skot/hashat/README.md

WIP - don't order PCBs yet!

# hashat
A Bitcoin ASIC mining HAT for Raspberry Pi

Some of the DIY mining enthusiats from the Open Source Miners United Discord have been scheming to make a Raspberry Pi Hat! Here is what we have so far.

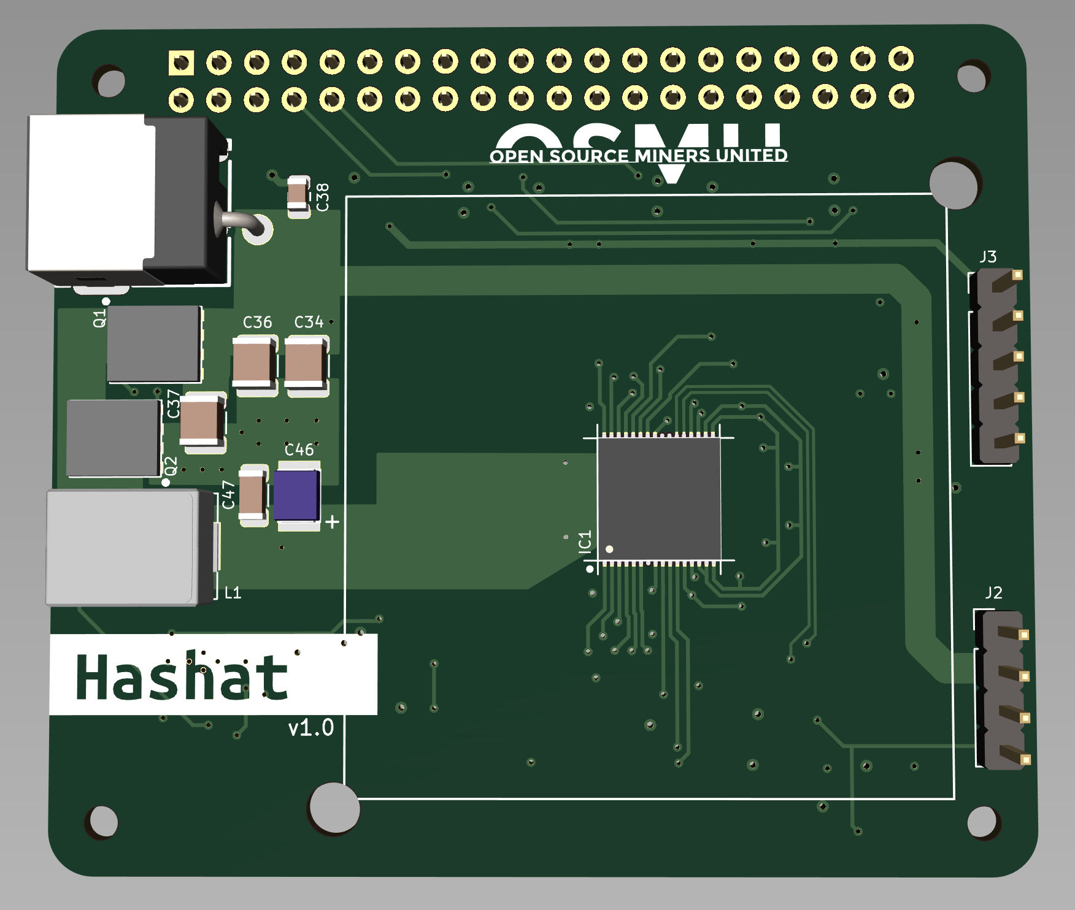
[picture p1: doc/render.png]
KiCAD Render
