skot/hashat/doc/OSMU-black.png

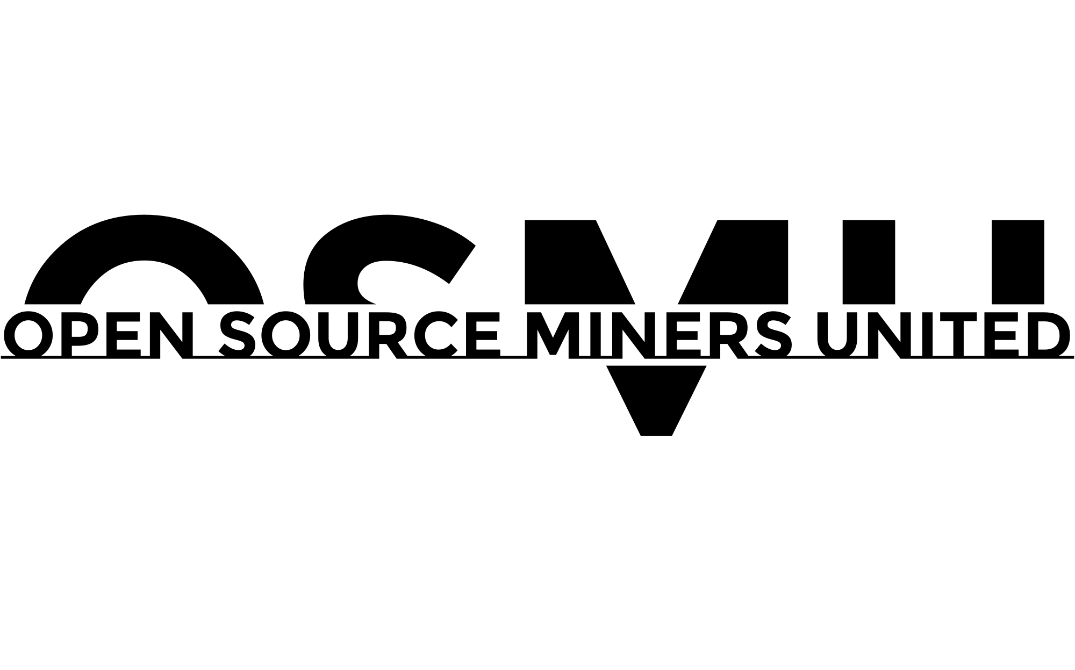
doc/OSMU-black.png
