skot/hashat/doc/OSMU-white.png

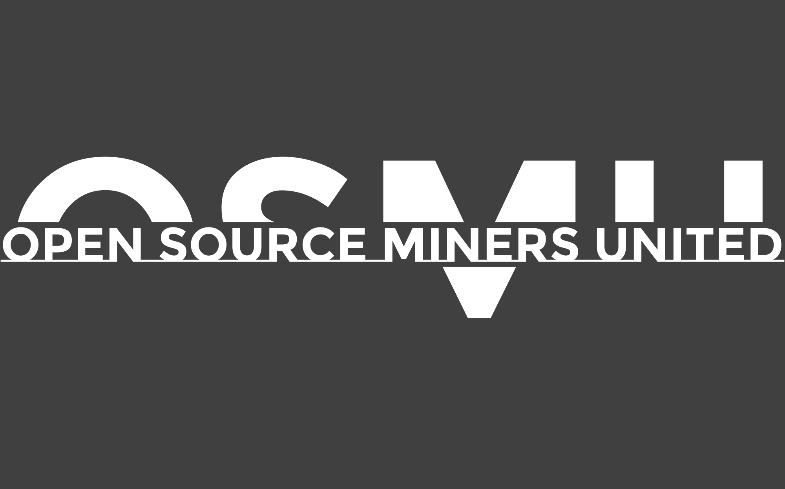
doc/OSMU-white.png
