skot/hashat/Manufacturing Files/Hashat BOM.xlsx

Sheet: BOM
Qty | Ref Des | Value | DK | PARTNO | DNP
18 | C2, C3, C4, C5, C6, C8, C10, C11, C12, C14, C15, C16, C17, C18, C19, C22, C24, C44 | 1uF | 587-5514-1-ND | EMK105BJ105MV-F
12 | C7, C9, C21, C23, C25, C26, C29, C31, C33, C35, C42, C48 | 0.1uF | 1292-1639-1-ND | 0402X104K100CT
1 | C13 | 330uF | 718-1028-1-ND | 293D337X9010E2TE3
1 | C20 | 2.2uF | 478-KGM05AR51A225MHCT-ND | KGM05AR51A225MH
1 | C28 | 220uF | 732-8422-1-ND | 865080345012
1 | C32 | 470pF | 1276-1566-1-ND | CL05B471KB5NNNC
3 | C34, C36, C37 | 47uF | 490-6539-1-ND | GRM32ER61C476KE15L
1 | C38 | 1uF | 1276-6471-1-ND | CL21B105KOFNNNG
1 | C39 | 3.3nF | 1276-1552-1-ND | CL05B332KB5NNNC
1 | C40 | 180pF | 311-1114-1-ND | CC0805JRNPO9BN181
1 | C41 | 1.5nF | 311-1128-1-ND | CC0805KRX7R9BB152
1 | C43 | 10uF | 1276-1096-1-ND | CL21A106KOQNNNE
1 | C45 | 470pF | 1292-1580-1-ND | 0805B471K500CT
1 | C46 | 220uF | P16200CT-ND | 2R5TPE220MAFB
1 | C47 | 100uF | 445-6008-1-ND | C3216X5R0J107M160AB
1 | DC1 | DC-044K-D025
1 | IC1 | BM1397_mode1
1 | J1 | Raspberry_Pi_2_3
1 | J2 | Conn_01x04
1 | J3 | Conn_01x05
1 | L1 | 150nH | 513-1568-1-ND | FP1005R1-R15-R
2 | Q1, Q2 | CSD17311Q5 | 296-27625-1-ND | CSD17311Q5
1 | R1 | 1k | YAG2306CT-ND | RT0402BRE071KL | DNP
1 | R2 | 1k | YAG2306CT-ND | RT0402BRE071KL
2 | R3, R4 | 0 | RMCF0402ZT0R00 | RMCF0402ZT0R00CT-ND | DNP
1 | R5 | 0 | RMCF0402ZT0R00 | RMCF0402ZT0R00CT-ND
2 | R6, R9 | 10k | 311-10KJRCT-ND | RC0402JR-0710KL
2 | R7, R8 | 100 | RMCF0402FT100RCT-ND | RMCF0402FT100R
1 | R10 | 3.83k | 311-3.83KLRCT-ND | RC0402FR-073K83L
1 | R11 | 100k | 311-100KJRCT-ND | RC0402JR-07100KL
1 | R12 | 4.12k | RMCF0402FT4K12CT-ND | RMCF0402FT4K12
1 | R13 | 1.33k | 311-1.33KLRCT-ND | RC0402FR-071K33L
1 | R14 | 4.99k | 311-4.99KLRCT-ND | RC0402FR-074K99L
1 | R15 | 3.32k | 311-3.32KLRCT-ND | RC0402FR-073K32L
1 | R16 | 80k | 311-80.6KLRCT-ND | RC0402FR-0780K6L
1 | R17 | 80k | 311-80.6KLRCT-ND | RC0402FR-0780K6L | DNP
1 | R36 | 5.6k | 13-RC0402FR-135K6LCT-ND | RC0402FR-135K6L
1 | U2 | LN1134A182MR-G
3 | U3, U5, U8 | SN74LVC1T45DBVR
1 | U4 | SGM2036-ADJYN5G/TR
1 | U7 | EMC2101-R | EMC2101-R-ACZL-CT-ND | EMC2101-R-ACZL-TR
1 | U9 | TPS40305 | 296-37445-1-ND | TPS40305DRCR
1 | U10 | DS4432U+ | DS4432U+-ND | DS4432U+
1 | X1 | OT322525MJBA4SL

Sheet: DK Order
Qty | Ref Des | DK
18 | C2, C3, C4, C5, C6, C8, C10, C11, C12, C14, C15, C16, C17, C18, C19, C22, C24, C44 | 587-5514-1-ND
12 | C7, C9, C21, C23, C25, C26, C29, C31, C33, C35, C42, C48 | 1292-1639-1-ND
1 | C13 | 718-1028-1-ND
1 | C20 | 478-KGM05AR51A225MHCT-ND
1 | C28 | 732-8422-1-ND
1 | C32 | 1276-1566-1-ND
3 | C34, C36, C37 | 490-6539-1-ND
1 | C38 | 1276-6471-1-ND
1 | C39 | 1276-1552-1-ND
1 | C40 | 311-1114-1-ND
1 | C41 | 311-1128-1-ND
1 | C43 | 1276-1096-1-ND
1 | C45 | 1292-1580-1-ND
1 | C46 | P16200CT-ND
1 | C47 | 445-6008-1-ND
1 | DC1
1 | IC1
1 | J1
1 | J2
1 | J3
1 | L1 | 513-1568-1-ND
2 | Q1, Q2 | 296-27625-1-ND
1 | R2 | YAG2306CT-ND
1 | R5 | RMCF0402ZT0R00
2 | R6, R9 | 311-10KJRCT-ND
2 | R7, R8 | RMCF0402FT100RCT-ND
1 | R10 | 311-3.83KLRCT-ND
1 | R11 | 311-100KJRCT-ND
1 | R12 | RMCF0402FT4K12CT-ND
1 | R13 | 311-1.33KLRCT-ND
1 | R14 | 311-4.99KLRCT-ND
1 | R15 | 311-3.32KLRCT-ND
1 | R16 | 311-80.6KLRCT-ND
1 | R36 | 13-RC0402FR-135K6LCT-ND
1 | U2
3 | U3, U5, U8
1 | U4
1 | U7 | EMC2101-R-ACZL-CT-ND
1 | U9 | 296-37445-1-ND
1 | U10 | DS4432U+-ND
1 | X1
