skot/hashat/3d/DRC0010J.stp

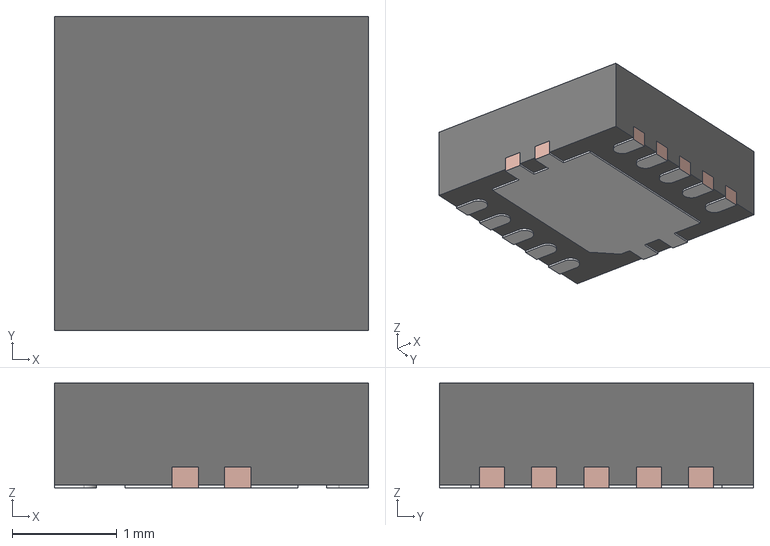
[picture p4: CAD file, 2023-06-09]
3d/DRC0010J.stp
3.00 x 3.00 x 1.00 mm
BODY-SON
FRAME-DRC0010J
