skot/hashat/3d/CUI_DEVICES_PJ-202AH.step

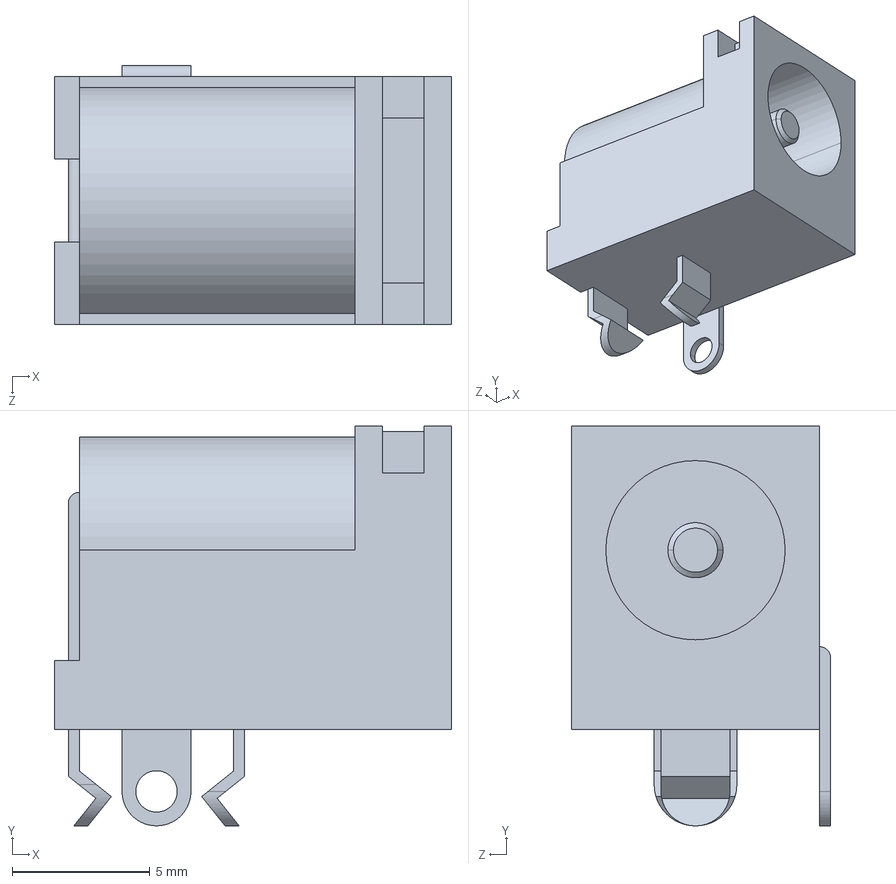
[picture p8: CAD file, 2023-04-22]
3d/CUI_DEVICES_PJ-202AH.step
14.4 x 14.5 x 9.40 mm
