skot/hashat/3d/470531000.stp

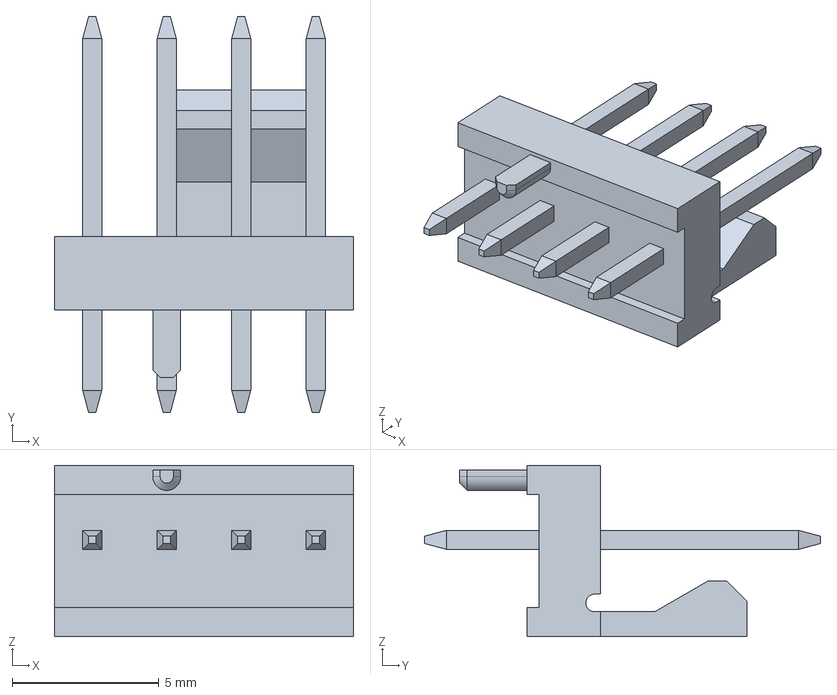
[picture p9: CAD file, 2023-05-16]
3d/470531000.stp
10.2 x 13.5 x 5.84 mm
