skot/hashat/Hashat.kicad_pcb

## KiCad design Hashat.kicad_pcb (2023-06-09)

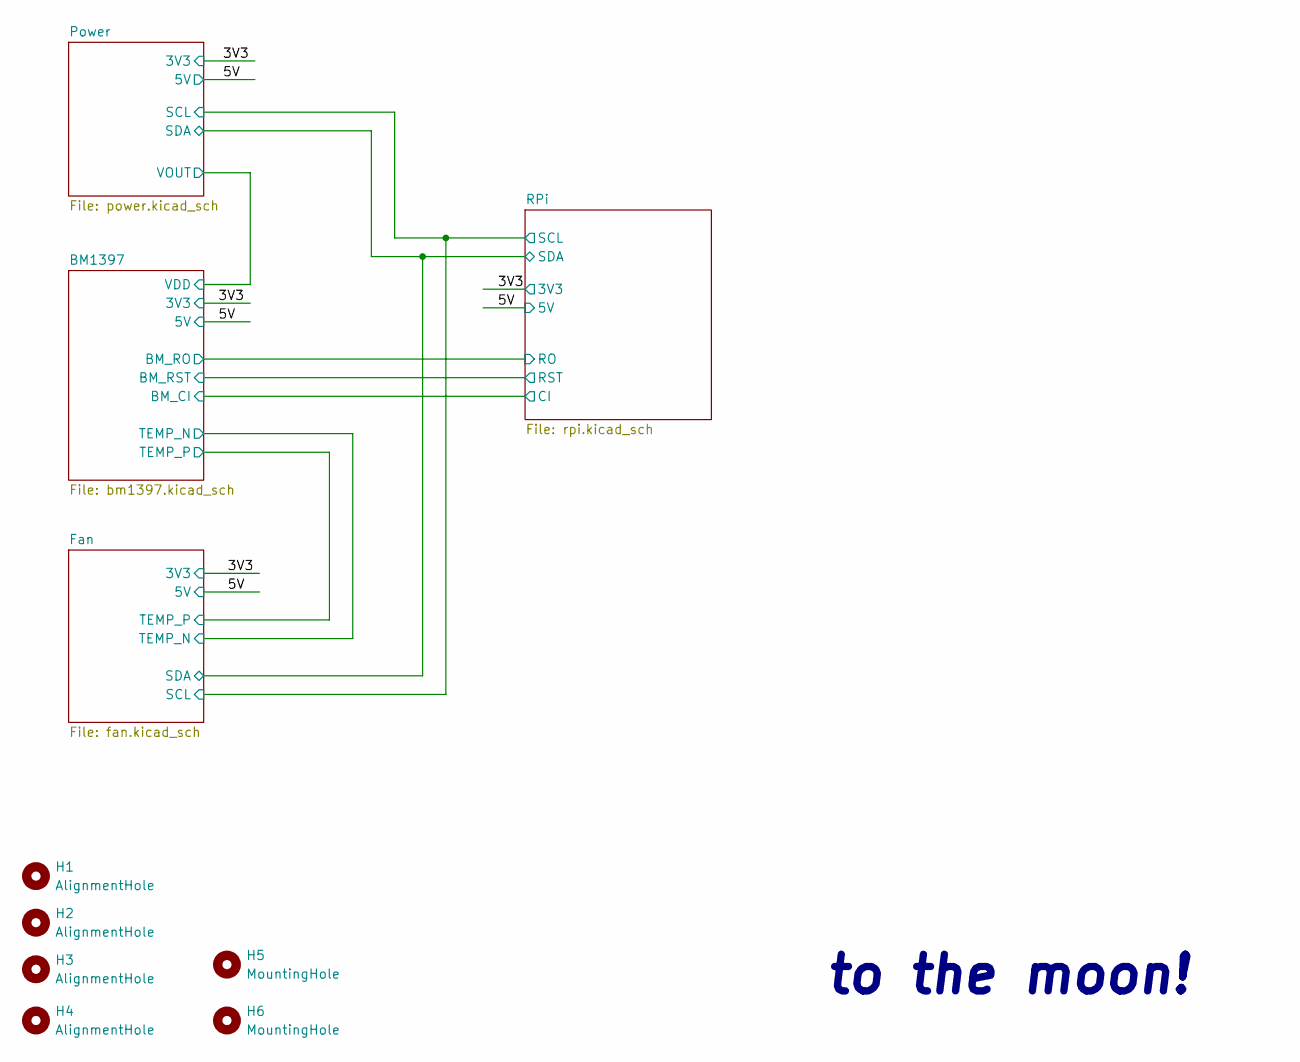
[picture p10: schematic Hashat.kicad_sch, The Hashat]

Parts:
H1, H2, H3, H4: AlignmentHole; MountingHole_2.2mm_M2
H5, H6: MountingHole; MountingHole_3.5mm

Notes on the sheet:
to the moon!

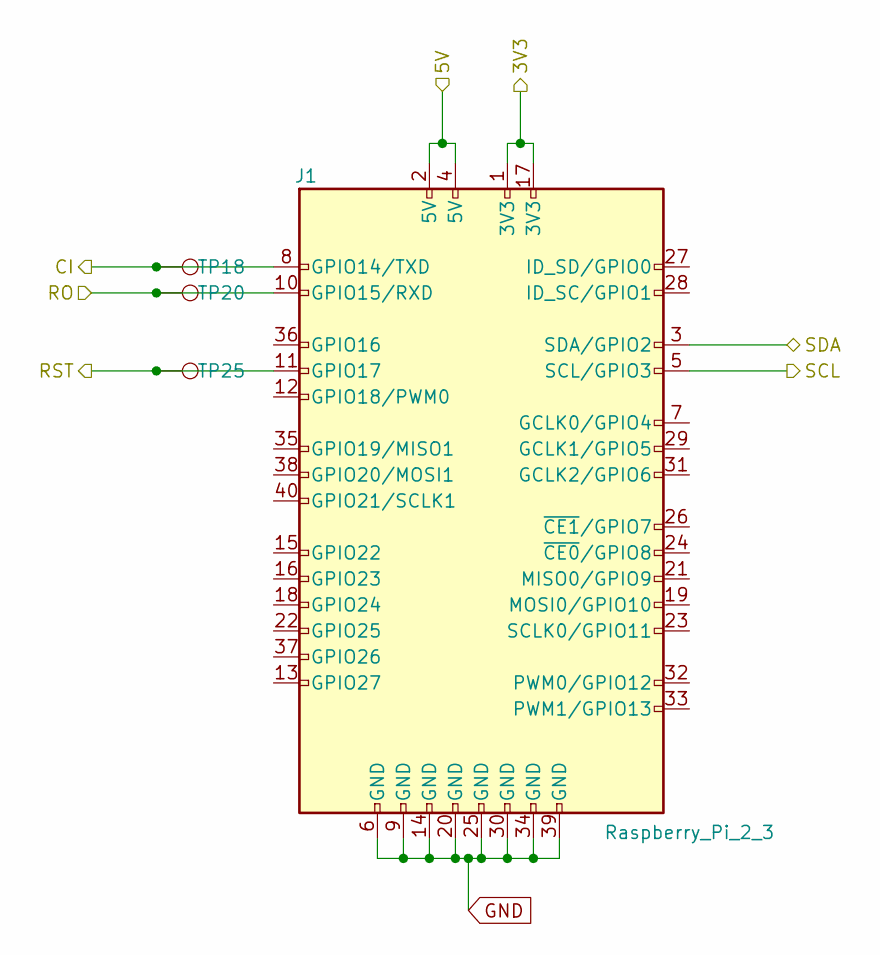
[picture p11: schematic rpi.kicad_sch]

Parts:
J1: Raspberry_Pi_2_3; ESQ-120-14-T-D
TP18, TP20, TP25: TestPoint; TestPoint_Pad_D1.5mm

Connections:
/3V3: J1.1 (3V3), J1.17 (3V3); also elsewhere on the board
/5V: J1.2 (5V), J1.4 (5V); also elsewhere on the board
/BM1397/BM_CI: J1.8 (GPIO14/TXD), TP18.1; also elsewhere on the board
/BM1397/BM_RO: J1.10 (GPIO15/RXD), TP20.1; also elsewhere on the board
/BM1397/BM_RST: J1.11 (GPIO17), TP25.1; also elsewhere on the board
/Fan/SCL: J1.5 (SCL/GPIO3); also elsewhere on the board
/Fan/SDA: J1.3 (SDA/GPIO2); also elsewhere on the board
GND: J1.6 (GND), J1.9 (GND), J1.14 (GND), J1.20 (GND), J1.25 (GND), J1.30 (GND), J1.34 (GND), J1.39 (GND); also elsewhere on the board

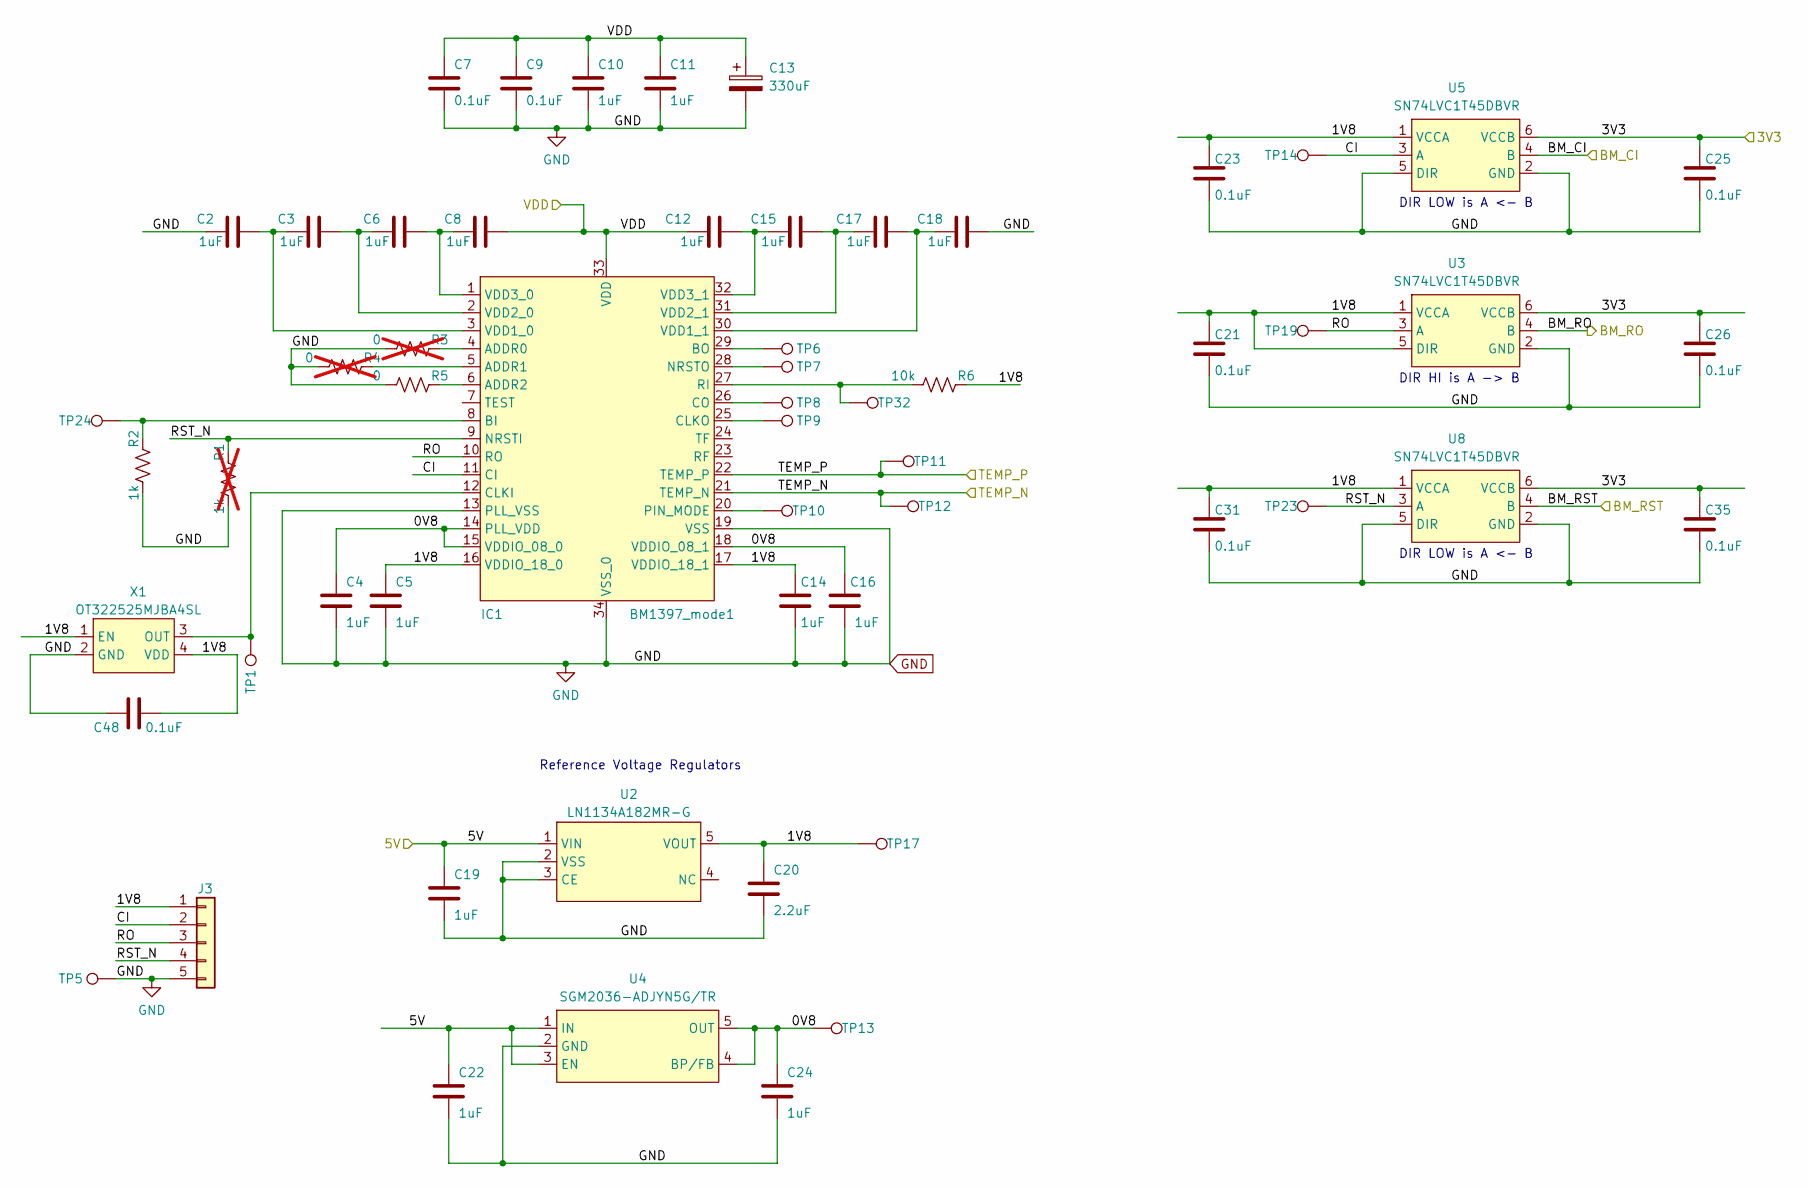
[picture p12: schematic bm1397.kicad_sch]

Parts:
C2, C3, C4, C5, C6, C8, C10, C11, C12, C14, C15, C16, C17, C18: 587-5514-1-ND; C_0402_1005Metric; PARTNO EMK105BJ105MV-F
C7, C9, C21, C23, C25, C26, C31, C35, C48: 311-3342-1-ND; C_0402_1005Metric; PARTNO 0402X104K100CT
C13: 330uF; CP_EIA-7343-31_Kemet-D_Pad2.25x2.55mm_HandSolder; PARTNO 293D337X9010E2TE3
C19, C22, C24: 1uF; C_0402_1005Metric; PARTNO EMK105BJ105MV-F
C20: 2.2uF; C_0402_1005Metric; PARTNO KGM05AR51A225MH
IC1: BM1397_mode1; BM1397
J3: Conn_01x05; PinHeader_1x05_P2.54mm_Vertical
R1: 1k; R_0402_1005Metric; PARTNO RT0402BRE071KL; not fitted
R2: 1k; R_0402_1005Metric; PARTNO RT0402BRE071KL
R3, R4: 0; R_0402_1005Metric; PARTNO RMCF0402ZT0R00CT-ND; not fitted
R5: 0; R_0402_1005Metric; PARTNO RMCF0402ZT0R00CT-ND
R6: 10k; R_0402_1005Metric; PARTNO RC0402JR-0710KL
TP1, TP5, TP6, TP7, TP8, TP9, TP10, TP11, TP12, TP13, TP14, TP17, TP19, TP23, TP24, TP32: TestPoint; TestPoint_Pad_D1.5mm
U2: LN1134A182MR-G; SOT-23-5_L3.0-W1.7-P0.95-LS2.8-BR; LCSC Part C141424
U3, U5, U8: SN74LVC1T45DBVR; SOT-23-6_L2.9-W1.6-P0.95-LS2.8-BR; LCSC Part C7843
U4: SGM2036-ADJYN5G/TR; SOT-23-5_L3.0-W1.7-P0.95-LS2.8-BR; LCSC Part C194594
X1: OT322525MJBA4SL; OSC-SMD_4P-L3.2-W2.5-BL; LCSC Part C669088

Connections:
/3V3: C25.1, C26.1, C35.1, U3.6 (VCCB), U5.6 (VCCB), U8.6 (VCCB); also elsewhere on the board
/5V: C19.1, C22.1, U2.1 (VIN), U4.1 (IN), U4.3 (EN); also elsewhere on the board
/BM1397/0V8: C4.1, C16.1, C24.1, IC1.14 (PLL_VDD), IC1.15 (VDDIO_08_0), IC1.18 (VDDIO_08_1), TP13.1, U4.4 (BP/FB), U4.5 (OUT)
/BM1397/1V8: C5.1, C14.1, C20.1, C21.1, C23.1, C31.1, C48.2, IC1.16 (VDDIO_18_0), IC1.17 (VDDIO_18_1), J3.1, R6.2, TP17.1, U2.5 (VOUT), U3.1 (VCCA), U3.5 (DIR), U5.1 (VCCA), U8.1 (VCCA), X1.1 (EN), X1.4 (VDD)
/BM1397/BM_CI: U5.4 (B); also elsewhere on the board
/BM1397/BM_RO: U3.4 (B); also elsewhere on the board
/BM1397/BM_RST: U8.4 (B); also elsewhere on the board
/BM1397/CI: IC1.11 (CI), J3.2, TP14.1, U5.3 (A)
/BM1397/RO: IC1.10 (RO), J3.3, TP19.1, U3.3 (A)
/BM1397/RST_N: IC1.9 (NRSTI), J3.4, R1.2, TP23.1, U8.3 (A)
/BM1397/TEMP_N: IC1.21 (TEMP_N), TP12.1; also elsewhere on the board
/BM1397/TEMP_P: IC1.22 (TEMP_P), TP11.1; also elsewhere on the board
/BM1397/VDD: C7.1, C8.2, C9.1, C10.1, C11.1, C12.1, C13.1, IC1.33 (VDD); also elsewhere on the board
GND: C2.1, C4.2, C5.2, C7.2, C9.2, C10.2, C11.2, C13.2, C14.2, C16.2, C18.2, C19.2, C20.2, C21.2, C22.2, C23.2, C24.2, C25.2, C26.2, C31.2, C35.2, C48.1, IC1.13 (PLL_VSS), IC1.19 (VSS), IC1.34 (VSS_0), J3.5, R1.1, R2.1, R3.1, R4.1, R5.1, TP5.1, U2.2 (VSS), U2.3 (CE), U3.2 (GND), U4.2 (GND), U5.2 (GND), U5.5 (DIR), U8.2 (GND), U8.5 (DIR), X1.2 (GND); also elsewhere on the board
unnamed: IC1.4 (ADDR0), R3.2
unnamed: IC1.5 (ADDR1), R4.2
unnamed: IC1.6 (ADDR2), R5.2
unnamed: IC1.8 (BI), R2.2, TP24.1
unnamed: IC1.29 (BO), TP6.1
unnamed: IC1.12 (CLKI), TP1.1, X1.3 (OUT)
unnamed: IC1.25 (CLKO), TP9.1
unnamed: IC1.26 (CO), TP8.1
unnamed: IC1.28 (NRSTO), TP7.1
unnamed: IC1.20 (PIN_MODE), TP10.1
unnamed: IC1.27 (RI), R6.1, TP32.1
unnamed: C2.2, C3.1, IC1.3 (VDD1_0)
unnamed: C17.2, C18.1, IC1.30 (VDD1_1)
unnamed: C3.2, C6.1, IC1.2 (VDD2_0)
unnamed: C15.2, C17.1, IC1.31 (VDD2_1)
unnamed: C6.2, C8.1, IC1.1 (VDD3_0)
unnamed: C12.2, C15.1, IC1.32 (VDD3_1)

Notes on the sheet:
Reference Voltage Regulators
DIR HI is A -> B
DIR LOW is A <- B

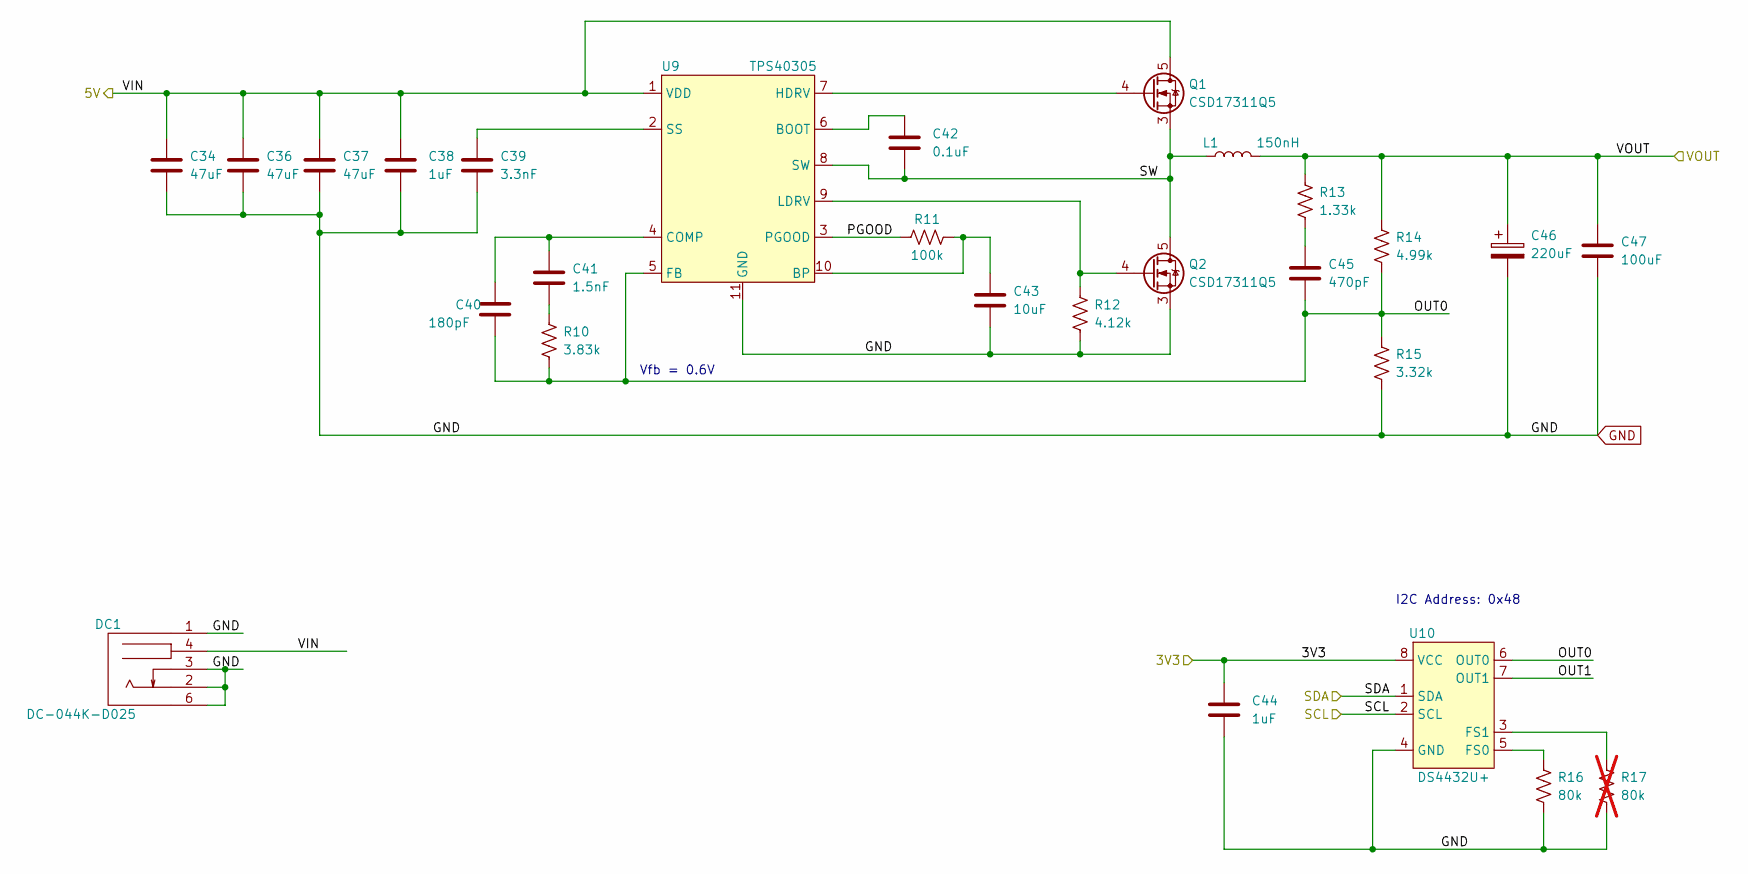
[picture p13: schematic power.kicad_sch]

Parts:
C34, C36, C37: 47uF; C_1210_3225Metric; PARTNO GRM32ER61C476KE15L
C38: 1uF; C_0805_2012Metric; PARTNO CL21B105KOFNNNG
C39: 3.3nF; C_0402_1005Metric; PARTNO CL05B332KB5NNNC
C40: 180pF; C_0805_2012Metric; PARTNO CC0805JRNPO9BN181
C41: 1.5nF; C_0805_2012Metric; PARTNO CC0805KRX7R9BB152
C42: 0.1uF; C_0402_1005Metric; PARTNO 0402X104K100CT
C43: 10uF; C_0805_2012Metric; PARTNO CL21A106KOQNNNE
C44: 1uF; C_0402_1005Metric; PARTNO EMK105BJ105MV-F
C45: 470pF; C_0805_2012Metric; PARTNO 0805B471K500CT
C46: 220uF; CAP_2R5TPE220MAFB; PARTNO 2R5TPE220MAFB
C47: 100uF; C_1206_3216Metric; PARTNO C3216X5R0J107M160AB
DC1: DC-044K-D025; DC-IN-TH_DC-044K-D025; LCSC Part C963204
L1: 150nH; FP1005R1-R15-R; PARTNO FP1005R1-R15-R
Q1, Q2: CSD17311Q5; PARTNO CSD17311Q5; LCSC Part C139640
R10: 3.83k; R_0402_1005Metric; PARTNO RC0402FR-073K83L
R11: 100k; R_0402_1005Metric; PARTNO RC0402JR-07100KL
R12: 4.12k; R_0402_1005Metric; PARTNO RMCF0402FT4K12
R13: 1.33k; R_0402_1005Metric; PARTNO RC0402FR-071K33L
R14: 4.99k; R_0402_1005Metric; PARTNO RC0402FR-074K99L
R15: 3.32k; R_0402_1005Metric; PARTNO RC0402FR-073K32L
R16: 80k; R_0402_1005Metric; PARTNO RC0402FR-0780K6L
R17: 80k; R_0402_1005Metric; PARTNO RC0402FR-0780K6L; not fitted
U9: TPS40305; PARTNO TPS40305DRCR; LCSC Part C140285
U10: DS4432U+; TSSOP-8_3x3mm_P0.65mm; PARTNO DS4432U+; LCSC Part C2679620

Connections:
/3V3: C44.1, U10.8 (VCC); also elsewhere on the board
/5V: C34.1, C36.1, C37.1, C38.1, DC1.4, Q1.5 (D), U9.1 (VDD); also elsewhere on the board
/BM1397/VDD: C46.1, C47.1, L1.2, R13.1, R14.1; also elsewhere on the board
/Fan/SCL: U10.2 (SCL); also elsewhere on the board
/Fan/SDA: U10.1 (SDA); also elsewhere on the board
/Power/OUT0: C40.2, C45.2, R10.2, R14.2, R15.1, U9.5 (FB), U10.6 (OUT0)
/Power/OUT1: U10.7 (OUT1)
/Power/PGOOD: R11.1, U9.3 (PGOOD)
/Power/SW: C42.2, L1.1, Q1.1, Q1.2, Q1.3 (S), Q2.5 (D), U9.8 (SW)
GND: C34.2, C36.2, C37.2, C38.2, C39.2, C43.2, C44.2, C46.2, C47.2, DC1.1, DC1.2, DC1.3, DC1.6, Q2.1, Q2.2, Q2.3 (S), R12.2, R15.2, R16.2, R17.2, U9.11 (GND), U10.4 (GND); also elsewhere on the board
unnamed: C41.2, R10.1
unnamed: C45.1, R13.2
unnamed: Q1.4 (G), U9.7 (HDRV)
unnamed: Q2.4 (G), R12.1, U9.9 (LDRV)
unnamed: C42.1, U9.6 (BOOT)
unnamed: C43.1, R11.2, U9.10 (BP)
unnamed: C40.1, C41.1, U9.4 (COMP)
unnamed: C39.1, U9.2 (SS)
unnamed: R16.1, U10.5 (FS0)
unnamed: R17.1, U10.3 (FS1)

Notes on the sheet:
Vfb = 0.6V
I2C Address: 0x48

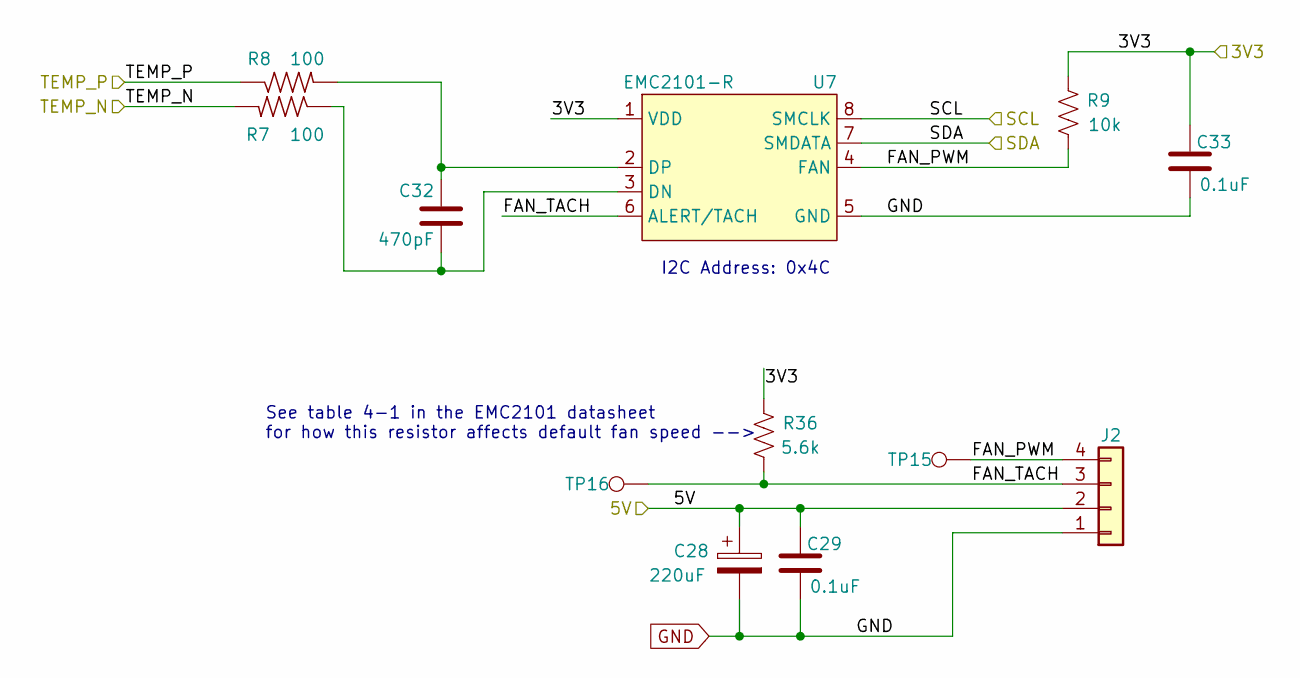
[picture p14: schematic fan.kicad_sch]

Parts:
C28: 220uF; CP_Elec_6.3x7.7; PARTNO 865080345012
C29, C33: 311-3342-1-ND; C_0402_1005Metric; PARTNO 0402X104K100CT
C32: 470pF; C_0402_1005Metric; PARTNO CL05B471KB5NNNC
J2: Conn_01x04; PinHeader_1x04_P2.54mm_Vertical
R7, R8: 100; R_0402_1005Metric; PARTNO RMCF0402FT100R
R9: 10k; R_0402_1005Metric; PARTNO RC0402JR-0710KL
R36: 5.6k; R_0402_1005Metric; PARTNO RC0402FR-135K6L
TP15, TP16: TestPoint; TestPoint_Pad_D1.5mm
U7: EMC2101-R; TSSOP-8_3x3mm_P0.65mm; PARTNO EMC2101-R-ACZL-TR; LCSC Part C626968

Connections:
/3V3: C33.1, R9.2, R36.2, U7.1 (VDD); also elsewhere on the board
/5V: C28.1, C29.1, J2.2; also elsewhere on the board
/BM1397/TEMP_N: R7.2; also elsewhere on the board
/BM1397/TEMP_P: R8.1; also elsewhere on the board
/Fan/FAN_PWM: J2.4, R9.1, TP15.1, U7.4 (FAN)
/Fan/FAN_TACH: J2.3, R36.1, TP16.1, U7.6 (ALERT/TACH)
/Fan/SCL: U7.8 (SMCLK); also elsewhere on the board
/Fan/SDA: U7.7 (SMDATA); also elsewhere on the board
GND: C28.2, C29.2, C33.2, J2.1, U7.5 (GND); also elsewhere on the board
unnamed: C32.2, R7.1, U7.3 (DN)
unnamed: C32.1, R8.2, U7.2 (DP)

Notes on the sheet:
See table 4-1 in the EMC2101 datasheet for how this resistor affects default fan speed -->
I2C Address: 0x4C

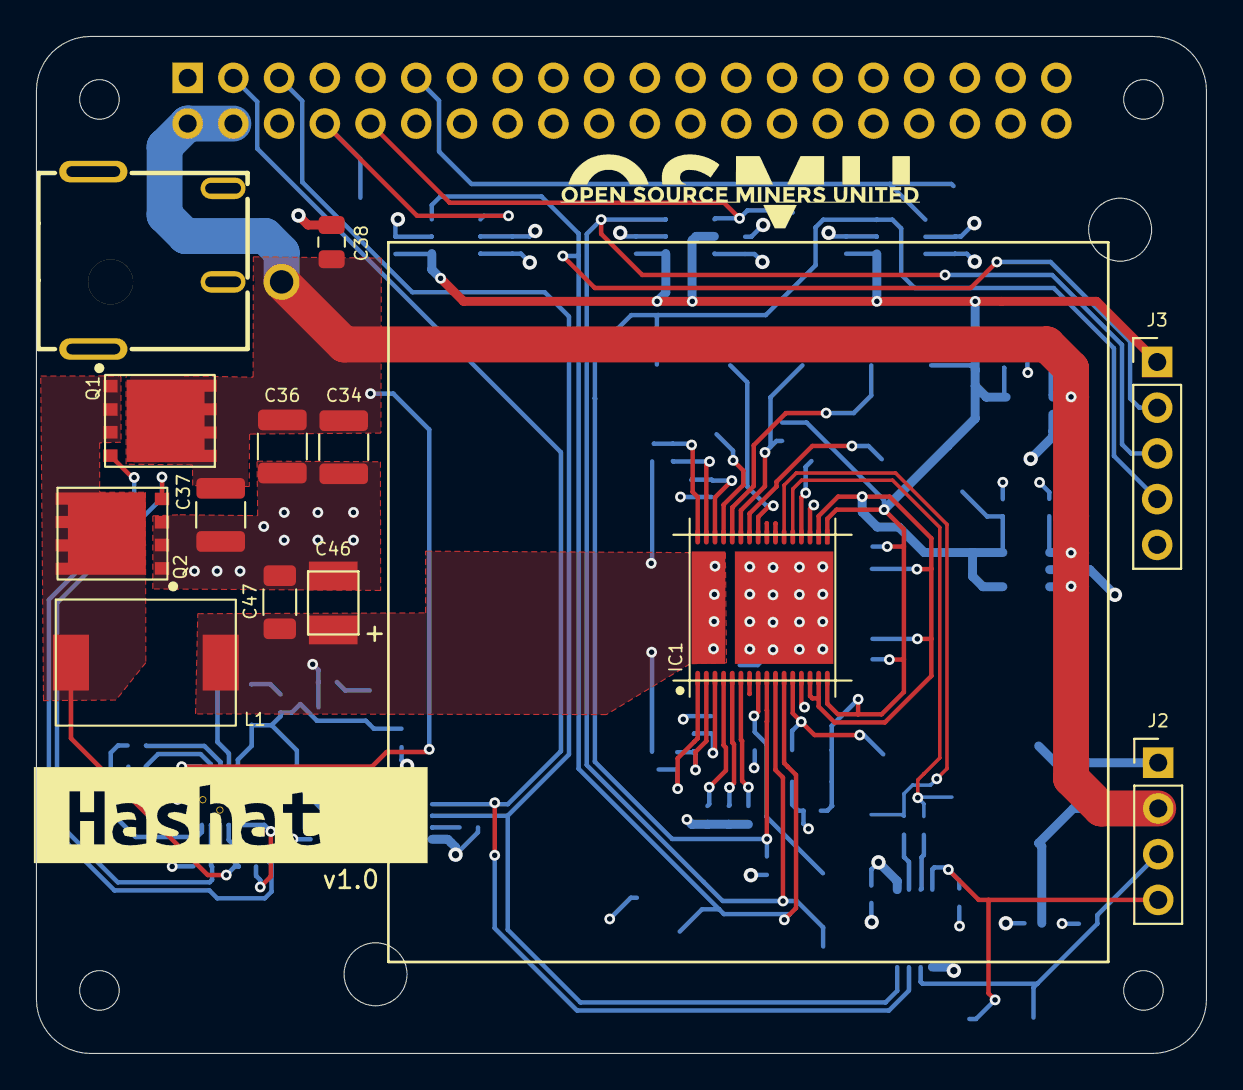
[picture p15: board Hashat.kicad_pcb from above]

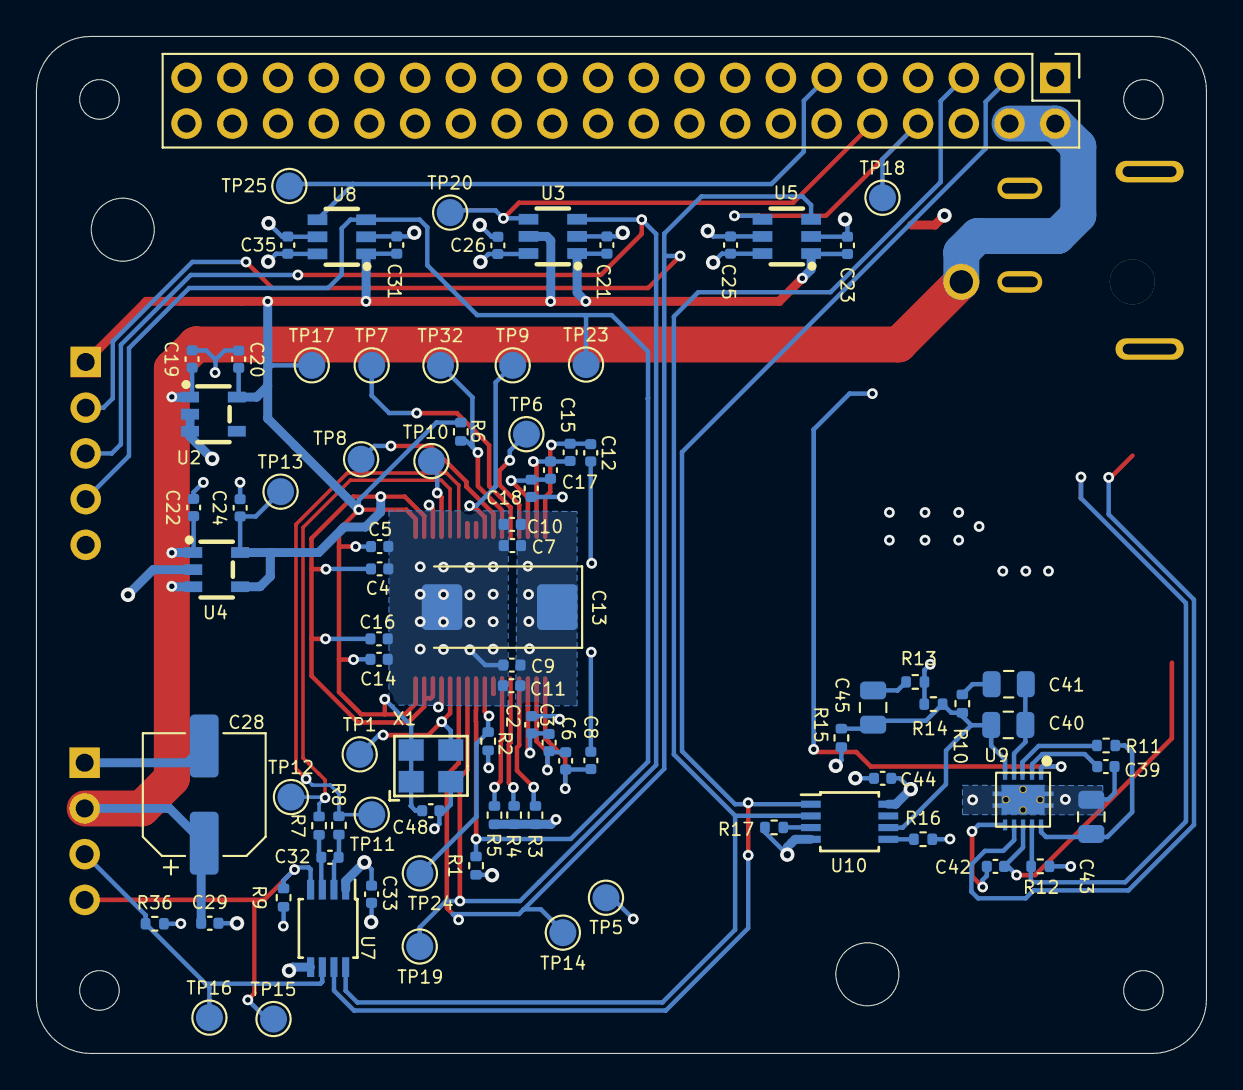
[picture p16: board Hashat.kicad_pcb from below]

Board: 4 copper layers, 65.0 x 56.5 mm, 108 parts (88 on the bottom side), 50 nets.

Other parts of the board:
kibuzzard-64828601: G***; kibuzzard-64828601
