skot/hashat/(commit log)

2023-04-22 initial import
    [Hashat.kicad_pcb, Hashat.kicad_sch]
2023-04-22 Added some placeholder sheets
    [Hashat.kicad_sch, bm1397.kicad_sch, fan.kicad_sch, power.kicad_sch]
2023-04-22 moved over a lot of schematic from the bitaxe
    [Hashat.kicad_pcb, Hashat.kicad_sch, bm1397.kicad_sch, fan.kicad_sch, power.kicad_sch, rpi.kicad_sch]
2023-04-22 more schematic
    [Hashat.kicad_sch, bm1397.kicad_sch, rpi.kicad_sch]
2023-04-22 more schematic. added the barrel power connector
    [CUI_DEVICES_PJ-202AH.step, Hashat.kicad_pcb, Hashat.kicad_sch]
2023-04-22 removed the camera/display cutouts from the edge cuts
    [Hashat.kicad_pcb]
2023-04-22 cleared up some part reference designator madness
    [Hashat.kicad_pcb, Hashat.kicad_sch, bm1397.kicad_sch, fan.kicad_sch, power.kicad_sch]
2023-04-22 swapped out the VCCIO LDOs for some LCSC versions
    [Hashat.kicad_pcb, Hashat.kicad_sch, bm1397.kicad_sch]
2023-04-22 added 4 discrete level shifters with LCSC stock
    [Hashat.kicad_sch, bm1397.kicad_sch]
2023-04-22 swapped 25MHz Osc for LCSC model
    [bm1397.kicad_sch]
2023-04-22 matched up layout ref with schematic
    [Hashat.kicad_pcb, Hashat.kicad_sch]
2023-04-22 cleanup. added LCSC fan connector
    [Hashat.kicad_pcb, Hashat.kicad_sch, bm1397.kicad_sch, fan.kicad_sch, power.kicad_sch]
2023-04-23 started on new LM5085 based buck design
    [Hashat.kicad_pcb, bm1397.kicad_sch, fan.kicad_sch, power.kicad_sch]
2023-04-23 added webench design docs
    [Hashat.kicad_sch]
2023-04-27 cleanup level shifters. LCRC inductor for buck
    [Hashat.kicad_sch, bm1397.kicad_sch, power.kicad_sch, rpi.kicad_sch]
2023-05-02 fully removed BI (and pulled down at the BM1397)
    [bm1397.kicad_sch, rpi.kicad_sch]
2023-05-16 adding 3D models. lots of placement. a little routing started
    [470531000.stp, DQH0008A.stp, FP1006V2-R.STEP, Hashat.kicad_pcb, bm1397.kicad_sch, power.kicad_sch]
2023-05-16 some more placing
    [2R5TPE220MAFB.step]
2023-06-07 more routing
    [Hashat.kicad_pcb, fan.kicad_sch]
2023-06-08 pretty much all the signals are routed
    [Hashat.kicad_pcb, Hashat.kicad_sch, bm1397.kicad_sch]
2023-06-08 finished routing
    [Hashat.kicad_pcb, bm1397.kicad_sch]
2023-06-08 got the silkscreen refdes all placed
    [Hashat.kicad_pcb]
2023-06-09 added sweet graphics
    [Hashat.kicad_pcb]
2023-06-09 added TPS40305 3d, and Hashat render
    [DRC0010J.stp, Hashat.kicad_pcb]
2023-06-09 cleanup, add OSMU logos
    [Hashat.kicad_sch]
2023-06-09 added initial BOM
    [Hashat BOM.xlsx, Hashat.kicad_sch, bm1397.kicad_sch, fan.kicad_sch, power.kicad_sch, rpi.kicad_sch]
2023-06-09 trace massaging
    [Hashat.kicad_pcb]
